brendena/Nordic_Pebble_Steel/README.md

# Nordic steel

The goal of this project is to replace the main motherboard in the pebble steel with newer parts.  Specifically the cpu will be a Nordic NRF52840.
