brendena/Nordic_Pebble_Steel/dev_board/README.md

# Goal
Is to have a dev board to test most of the features for a pebble like watch that runs on a nordic chip.

version
V0.2 - changed the IMU to LSM6DSOXTR, added DRV2605L for motor vibration. Switched the zebra connector around.  Added the zebra connector footprint.  
V0.1 - All most important parts are there.  Spi flash, 2 way of attaching display, Nordic som, charging circuit.
