brendena/Nordic_Pebble_Steel/dev_board/Dev_board_V0.3/README.md

# Changes
* Add i2c pull up resistors
* Connector cap on haptic feedback properly
* connect display signal to the adafruit display connector
* add holes and make board bigger for the watch to be attached to the board
* remove all the battery charging stuff
* on addrafruit display VDD is not connected
* add a 10 pin jtag programmer header
