brendena/Nordic_Pebble_Steel/dev_board/Dev_board_V0.3/Nrf52480_Dev_board/Nrf52480_Dev_board.kicad_pcb

## KiCad design dev_board/Dev_board_V0.3/Nrf52480_Dev_board/Nrf52480_Dev_board.kicad_pcb (2024-08-11)

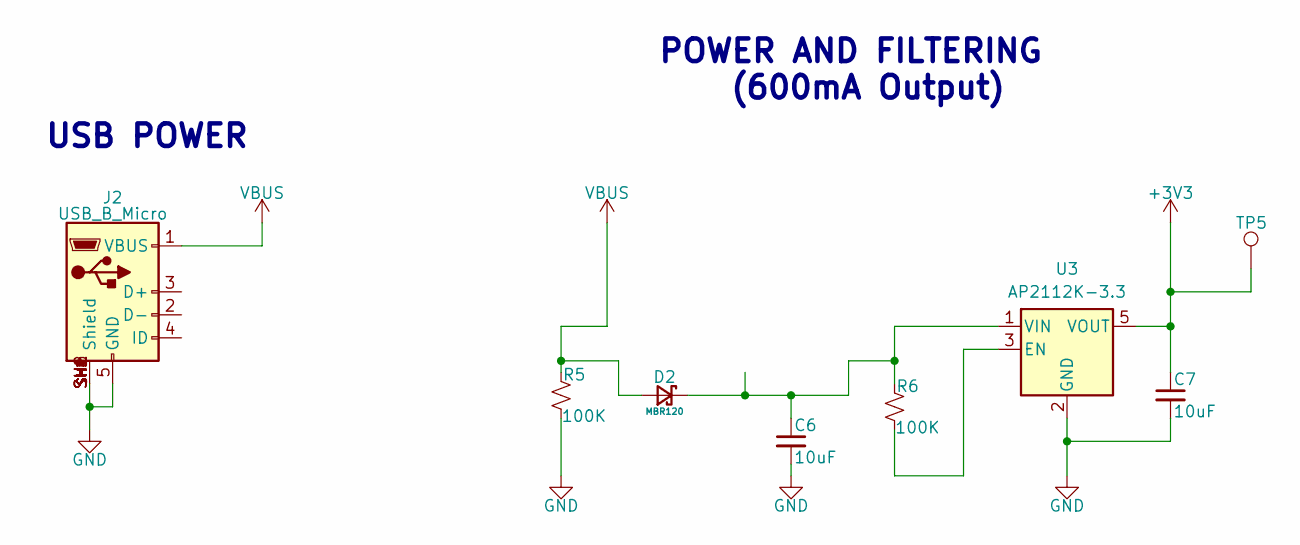
[picture p1: schematic Power.kicad_sch]

Parts:
C6, C7: 10uF; C_0603_1608Metric_Pad1.08x0.95mm_HandSolder
D2: MBR120; D_SOD-123F; MFR# MBR120LSFT1G
J2: USB_B_Micro; MOLEX_1050170001
R5, R6: 100K; R_0603_1608Metric_Pad0.98x0.95mm_HandSolder
TP5: TestPoint; TestPoint_Pad_1.5x1.5mm
U3: AP2112K-3.3; SOT-23-5

Connections:
+3V3: C7.1, TP5.1, U3.5 (VOUT); also elsewhere on the board
GND: C6.2, C7.2, J2.5 (GND), J2.SH1 (Shield), J2.SH2 (Shield), J2.SH3 (Shield), J2.SH4 (Shield), J2.SH5 (Shield), J2.SH6 (Shield), J2.SH7 (Shield), J2.SH8 (Shield), R5.1, U3.2 (GND); also elsewhere on the board
unnamed: C6.1, D2.1 (K), R6.2, U3.1 (VIN)
unnamed: R6.1, U3.3 (EN)
VBUS: D2.2 (A), J2.1 (VBUS), R5.2; also elsewhere on the board

Notes on the sheet:
USB POWER
POWER AND FILTERING (600mA Output)

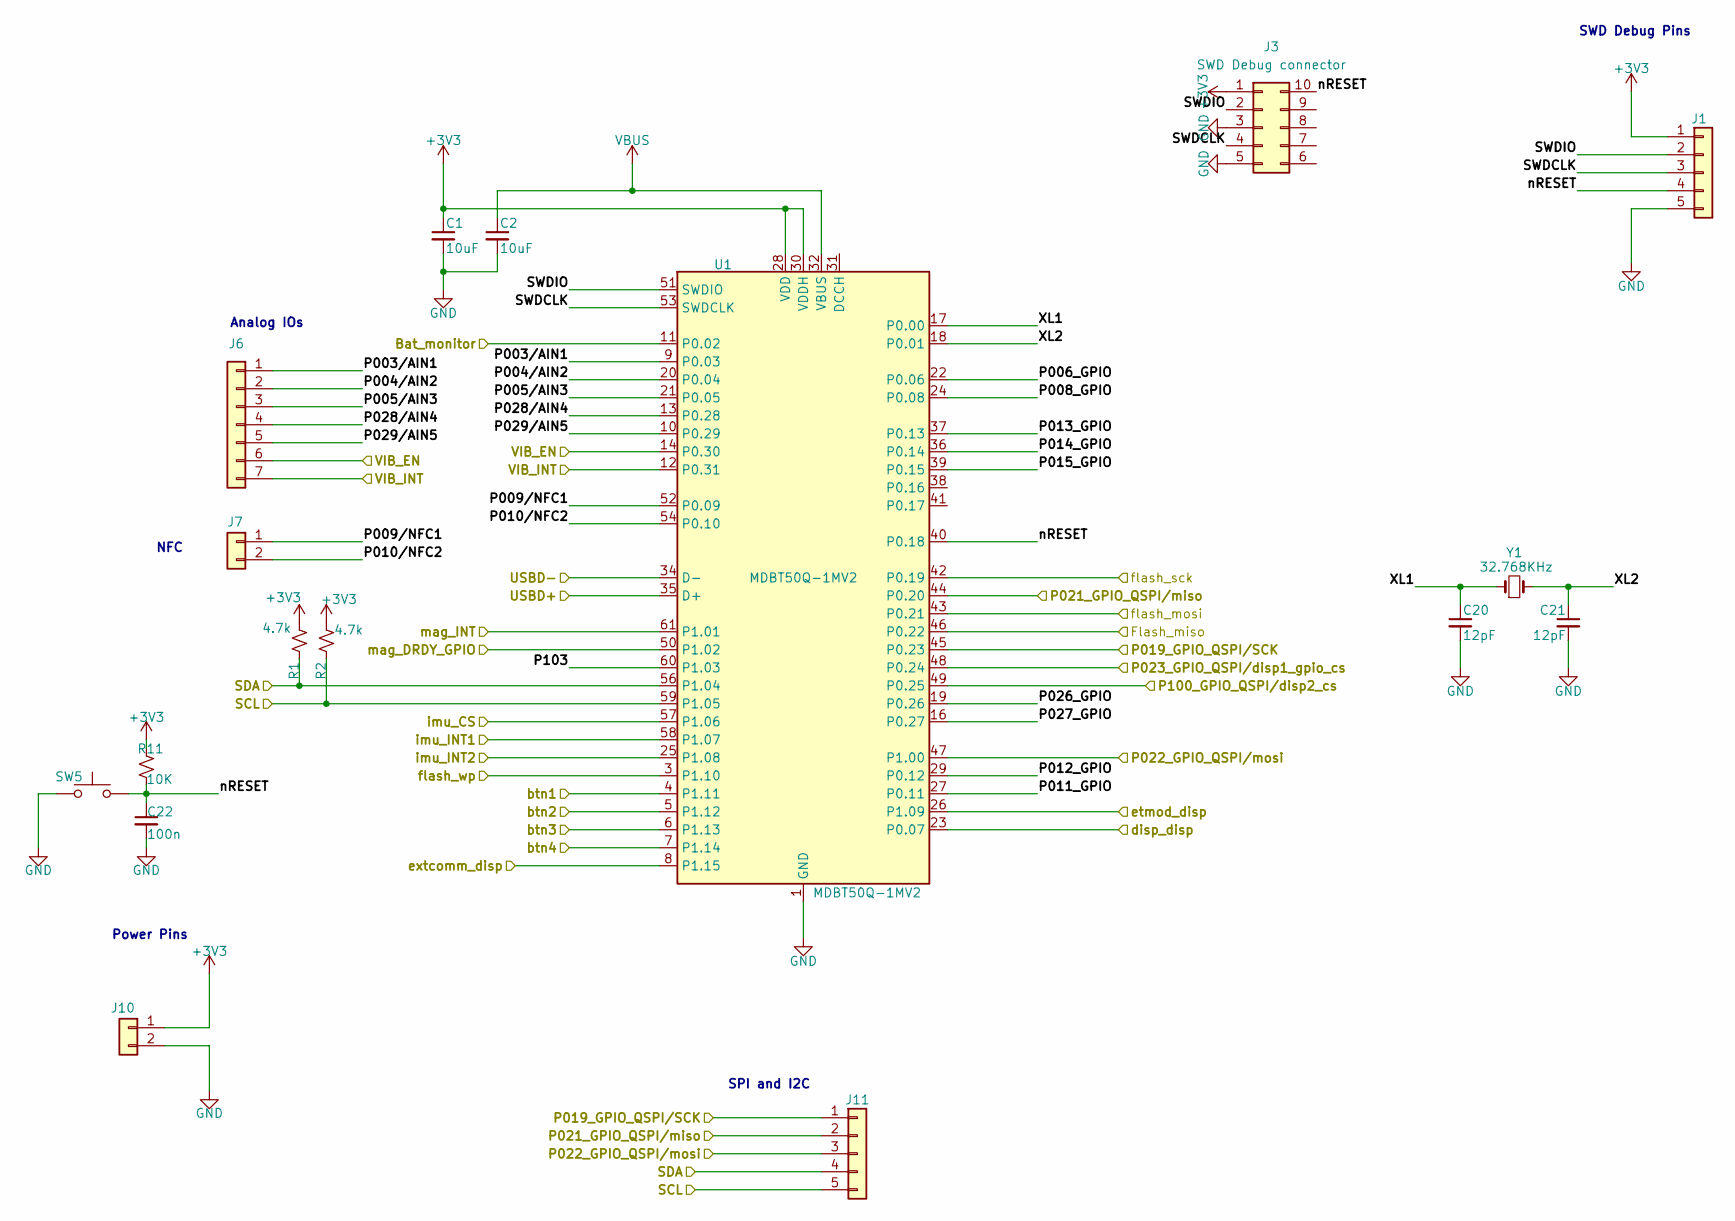
[picture p2: schematic nRF52840.kicad_sch]

Parts:
C1, C2: 10uF; C_0603_1608Metric_Pad1.08x0.95mm_HandSolder
C20, C21: 12pF; C_0603_1608Metric_Pad1.08x0.95mm_HandSolder
C22: 100n; C_0603_1608Metric_Pad1.08x0.95mm_HandSolder
J1, J11: Conn_01x05; PinHeader_1x05_P2.54mm_Vertical
J3: SWD Debug connector; PinHeader_2x05_P1.27mm_Vertical_SMD
J6: Conn_01x07; PinHeader_1x07_P2.54mm_Vertical
J7, J10: Conn_01x02; PinHeader_1x02_P2.54mm_Vertical
R1, R2: 4.7k; R_0603_1608Metric
R11: 10K; R_0603_1608Metric
SW5: SW_Push; SKRPACE010
U1: MDBT50Q-1MV2; Raytac_MDBT50Q; MFR# MDBT50Q-1MV2
Y1: 32.768KHz; Crystal_SMD_3215-2Pin_3.2x1.5mm

Connections:
+3V3: C1.1, J1.1, J3.1, J10.1, R1.1, R2.1, R11.2, U1.28 (VDD), U1.30 (VDDH); also elsewhere on the board
/Sensors/DISP2_CS: U1.49 (P0.25); also elsewhere on the board
/Sensors/Flash_miso: U1.46 (P0.22); also elsewhere on the board
/Sensors/SCL: J11.5, R2.2, U1.59 (P1.05); also elsewhere on the board
/Sensors/SDA: J11.4, R1.2, U1.56 (P1.04); also elsewhere on the board
/Sensors/VIB_EN: J6.6, U1.14 (P0.30); also elsewhere on the board
/Sensors/VIB_INT: J6.7, U1.12 (P0.31); also elsewhere on the board
/Sensors/btn1: U1.4 (P1.11); also elsewhere on the board
/Sensors/btn2: U1.5 (P1.12); also elsewhere on the board
/Sensors/btn3: U1.6 (P1.13); also elsewhere on the board
/Sensors/btn4: U1.7 (P1.14); also elsewhere on the board
/Sensors/disp1_GPIO_CS: U1.48 (P0.24); also elsewhere on the board
/Sensors/disp_disp: U1.23 (P0.07); also elsewhere on the board
/Sensors/etmod_disp: U1.26 (P1.09); also elsewhere on the board
/Sensors/extcomm_disp: U1.8 (P1.15); also elsewhere on the board
/Sensors/flash_mosi: U1.43 (P0.21); also elsewhere on the board
/Sensors/flash_sck: U1.42 (P0.19); also elsewhere on the board
/Sensors/flash_wp: U1.3 (P1.10); also elsewhere on the board
/Sensors/imu_CS: U1.57 (P1.06); also elsewhere on the board
/Sensors/imu_INT1: U1.58 (P1.07); also elsewhere on the board
/Sensors/imu_INT2: U1.25 (P1.08); also elsewhere on the board
/Sensors/mag_DRDY_GPIO: U1.50 (P1.02); also elsewhere on the board
/Sensors/mag_INT: U1.61 (P1.01); also elsewhere on the board
/Sensors/mosi: J11.3, U1.47 (P1.00); also elsewhere on the board
/Sensors/sck: J11.1, U1.45 (P0.23); also elsewhere on the board
/nRF52840/Bat_monitor: U1.11 (P0.02)
/nRF52840/P003/AIN1: J6.1, U1.9 (P0.03)
/nRF52840/P004/AIN2: J6.2, U1.20 (P0.04)
/nRF52840/P005/AIN3: J6.3, U1.21 (P0.05)
/nRF52840/P006_GPIO: U1.22 (P0.06)
/nRF52840/P008_GPIO: U1.24 (P0.08)
/nRF52840/P009/NFC1: J7.1, U1.52 (P0.09)
/nRF52840/P010/NFC2: J7.2, U1.54 (P0.10)
/nRF52840/P011_GPIO: U1.27 (P0.11)
/nRF52840/P012_GPIO: U1.29 (P0.12)
/nRF52840/P013_GPIO: U1.37 (P0.13)
/nRF52840/P014_GPIO: U1.36 (P0.14)
/nRF52840/P015_GPIO: U1.39 (P0.15)
/nRF52840/P021_GPIO_QSPI/miso: J11.2, U1.44 (P0.20)
/nRF52840/P026_GPIO: U1.19 (P0.26)
/nRF52840/P027_GPIO: U1.16 (P0.27)
/nRF52840/P028/AIN4: J6.4, U1.13 (P0.28)
/nRF52840/P029/AIN5: J6.5, U1.10 (P0.29)
/nRF52840/P103: U1.60 (P1.03)
/nRF52840/SWDCLK: J1.3, J3.4, U1.53 (SWDCLK)
/nRF52840/SWDIO: J1.2, J3.2, U1.51 (SWDIO)
/nRF52840/USBD+: U1.35 (D+)
/nRF52840/USBD-: U1.34 (D-)
/nRF52840/XL1: C20.1, U1.17 (P0.00), Y1.1
/nRF52840/XL2: C21.1, U1.18 (P0.01), Y1.2
/nRF52840/nRESET: C22.1, J1.4, J3.10, R11.1, SW5.2, U1.40 (P0.18)
GND: C1.2, C2.2, C20.2, C21.2, C22.2, J1.5, J3.3, J3.5, J10.2, SW5.1, U1.1 (GND), U1.2 (GND), U1.15 (GND), U1.33 (GND), U1.55 (GND); also elsewhere on the board
VBUS: C2.1, U1.32 (VBUS); also elsewhere on the board

Notes on the sheet:
Analog IOs
Power Pins
SPI and I2C
SWD Debug Pins
NFC

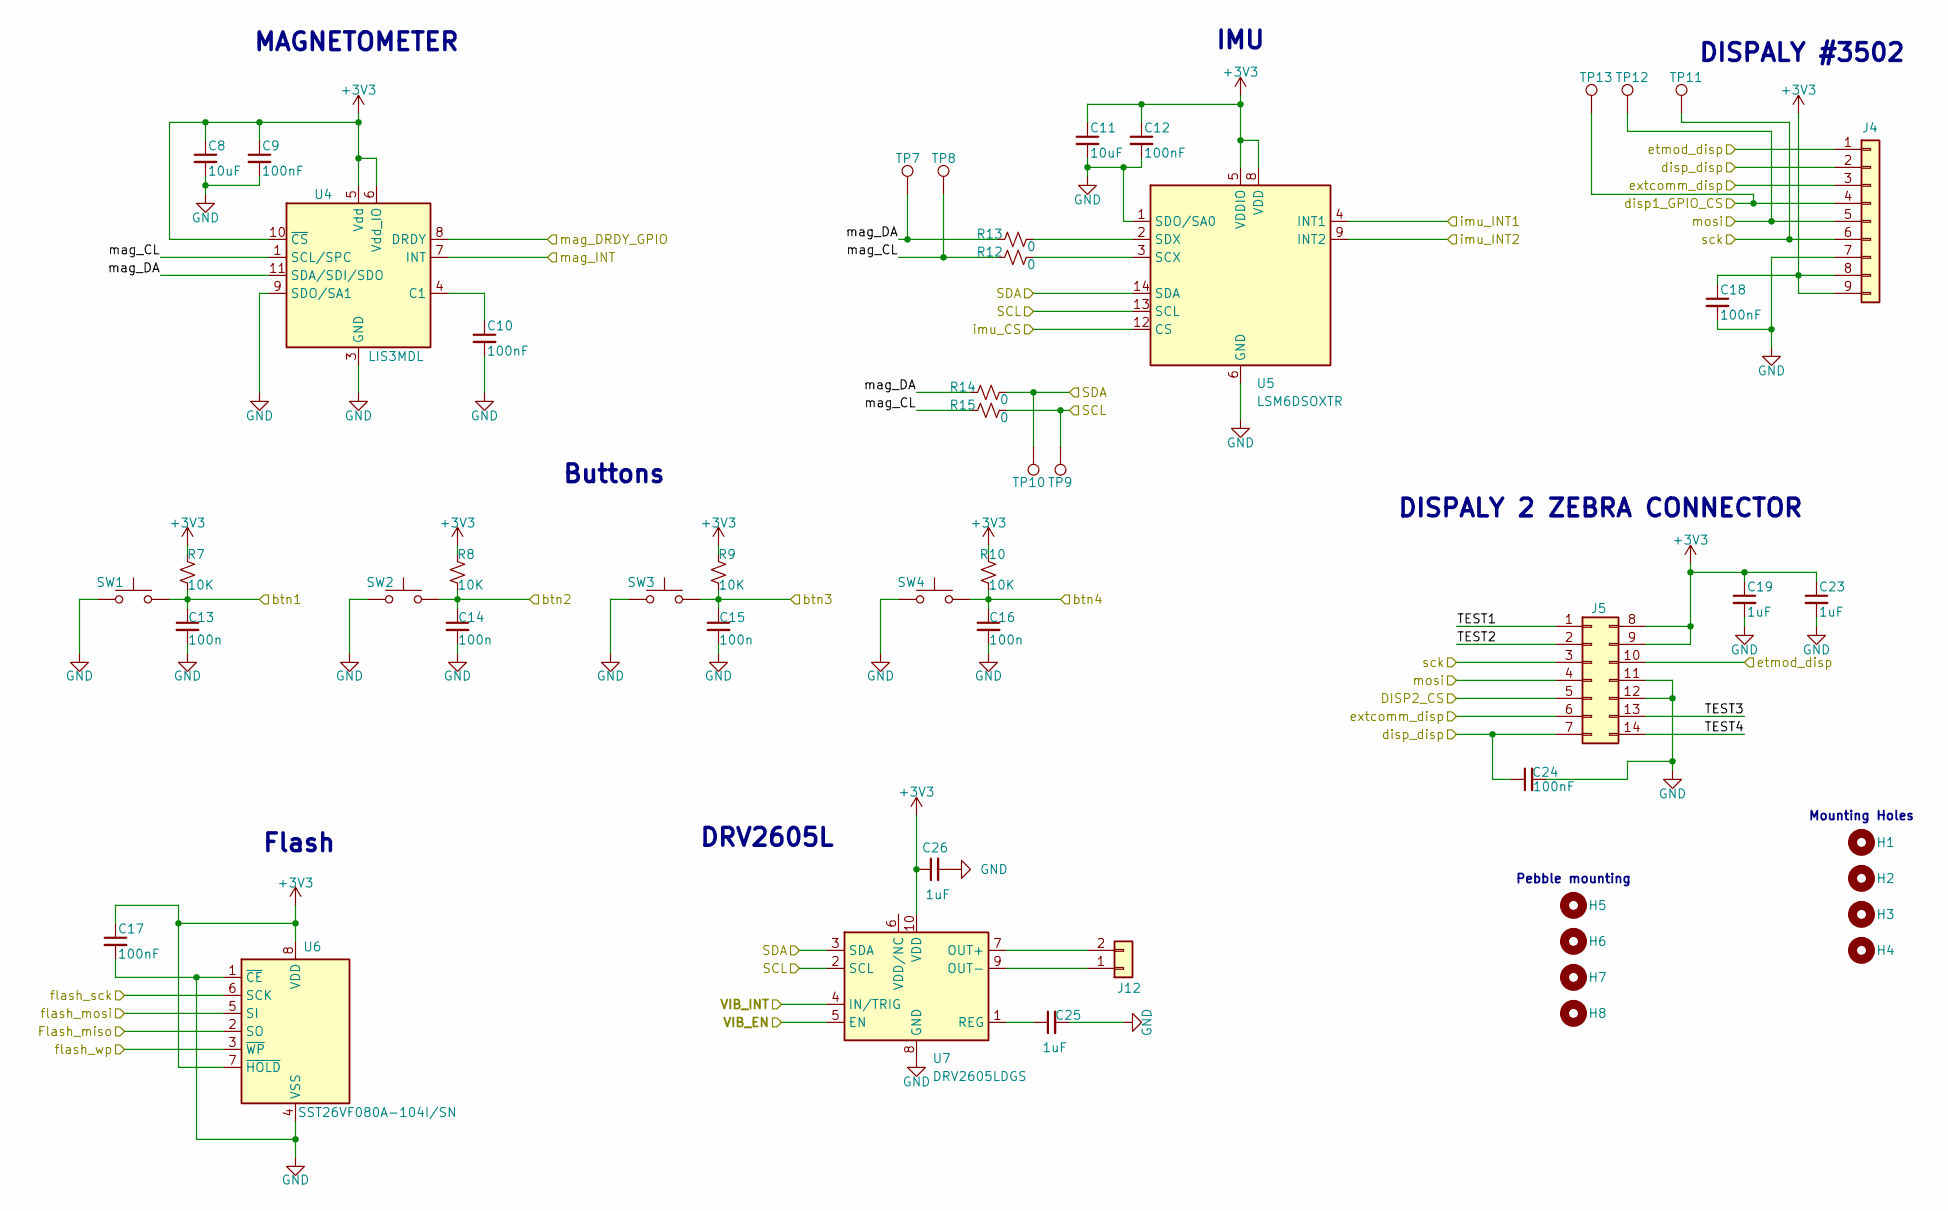
[picture p3: schematic Sensors.kicad_sch]

Parts:
C8, C11: 10uF; C_0603_1608Metric_Pad1.08x0.95mm_HandSolder
C9, C10, C12, C17, C18, C24: 100nF; C_0603_1608Metric_Pad1.08x0.95mm_HandSolder
C13, C14, C15, C16: 100n; C_0603_1608Metric_Pad1.08x0.95mm_HandSolder
C19, C23, C25, C26: 1uF; C_0603_1608Metric_Pad1.08x0.95mm_HandSolder
H1, H2, H3, H4: MountingHole; MountingHole_3.2mm_M3
H5, H6, H7, H8: MountingHole; MountingHole_2.1mm
J4: Conn_01x09; PinHeader_1x09_P2.54mm_Vertical
J5: Conn_02x07_Top_Bottom; Zebra_LS013B7DH01
J12: Conn_01x02; PinHeader_1x02_P2.54mm_Vertical
R7, R8, R9, R10: 10K; R_0603_1608Metric
R12, R13, R14, R15: 0; R_0603_1608Metric
SW1, SW2, SW3, SW4: SW_Push; SKRPACE010
TP7, TP8, TP9, TP10, TP11, TP12, TP13: TestPoint; TestPoint_Pad_1.5x1.5mm
U4: LIS3MDL; LGA-12_2x2mm_P0.5mm; MFR# LIS3MDLTR
U5: LSM6DSOXTR; LGA-14_3x2.5mm_P0.5mm_LayoutBorder3x4y; MFR# LSM6DSO16ISTR
U6: SST26VF080A-104I/SN; SOIC-8_3.9x4.9mm_P1.27mm; MFR# SST26VF080A-104I/SN
U7: DRV2605LDGS; VSSOP-10_3x3mm_P0.5mm

Connections:
+3V3: C8.1, C9.1, C11.1, C12.1, C17.1, C18.1, C19.1, C23.1, C26.1, J4.8, J4.9, J5.8, J5.9, R7.2, R8.2, R9.2, R10.2, U4.5 (Vdd), U4.6 (Vdd_IO), U4.10 (~CS), U5.5 (VDDIO), U5.8 (VDD), U6.7 (~HOLD), U6.8 (VDD), U7.10 (VDD); also elsewhere on the board
/Sensors/DISP2_CS: J5.5; also elsewhere on the board
/Sensors/Flash_miso: U6.2 (SO); also elsewhere on the board
/Sensors/SCL: R15.1, TP9.1, U5.13 (SCL), U7.2 (SCL); also elsewhere on the board
/Sensors/SDA: R14.1, TP10.1, U5.14 (SDA), U7.3 (SDA); also elsewhere on the board
/Sensors/TEST1: J5.1
/Sensors/TEST2: J5.2
/Sensors/TEST3: J5.13
/Sensors/TEST4: J5.14
/Sensors/VIB_EN: U7.5 (EN); also elsewhere on the board
/Sensors/VIB_INT: U7.4 (IN/TRIG); also elsewhere on the board
/Sensors/btn1: C13.1, R7.1, SW1.2; also elsewhere on the board
/Sensors/btn2: C14.1, R8.1, SW2.2; also elsewhere on the board
/Sensors/btn3: C15.1, R9.1, SW3.2; also elsewhere on the board
/Sensors/btn4: C16.1, R10.1, SW4.2; also elsewhere on the board
/Sensors/disp1_GPIO_CS: J4.4, TP13.1; also elsewhere on the board
/Sensors/disp_disp: C24.1, J4.2, J5.7; also elsewhere on the board
/Sensors/etmod_disp: J4.1, J5.10; also elsewhere on the board
/Sensors/extcomm_disp: J4.3, J5.6; also elsewhere on the board
/Sensors/flash_mosi: U6.5 (SI); also elsewhere on the board
/Sensors/flash_sck: U6.6 (SCK); also elsewhere on the board
/Sensors/flash_wp: U6.3 (~WP); also elsewhere on the board
/Sensors/imu_CS: U5.12 (CS); also elsewhere on the board
/Sensors/imu_INT1: U5.4 (INT1); also elsewhere on the board
/Sensors/imu_INT2: U5.9 (INT2); also elsewhere on the board
/Sensors/mag_CL: R12.2, R15.2, TP8.1, U4.1 (SCL/SPC)
/Sensors/mag_DA: R13.2, R14.2, TP7.1, U4.11 (SDA/SDI/SDO)
/Sensors/mag_DRDY_GPIO: U4.8 (DRDY); also elsewhere on the board
/Sensors/mag_INT: U4.7 (INT); also elsewhere on the board
/Sensors/mosi: J4.5, J5.4, TP12.1; also elsewhere on the board
/Sensors/sck: J4.6, J5.3, TP11.1; also elsewhere on the board
GND: C8.2, C9.2, C10.2, C11.2, C12.2, C13.2, C14.2, C15.2, C16.2, C17.2, C18.2, C19.2, C23.2, C24.2, C25.2, C26.2, J4.7, J5.11, J5.12, SW1.1, SW2.1, SW3.1, SW4.1, U4.2 (GND), U4.3 (GND), U4.9 (SDO/SA1), U4.12 (GND), U5.1 (SDO/SA0), U5.6 (GND), U5.7 (GND), U6.1 (~CE), U6.4 (VSS), U7.8 (GND); also elsewhere on the board
unnamed: J12.1, U7.9 (OUT-)
unnamed: J12.2, U7.7 (OUT+)
unnamed: C10.1, U4.4 (C1)
unnamed: R12.1, U5.3 (SCX)
unnamed: R13.1, U5.2 (SDX)
unnamed: C25.1, U7.1 (REG)

Notes on the sheet:
MAGNETOMETER
DISPALY #3502
Buttons
Mounting Holes
DISPALY 2 ZEBRA CONNECTOR
Pebble mounting
Flash
IMU
DRV2605L

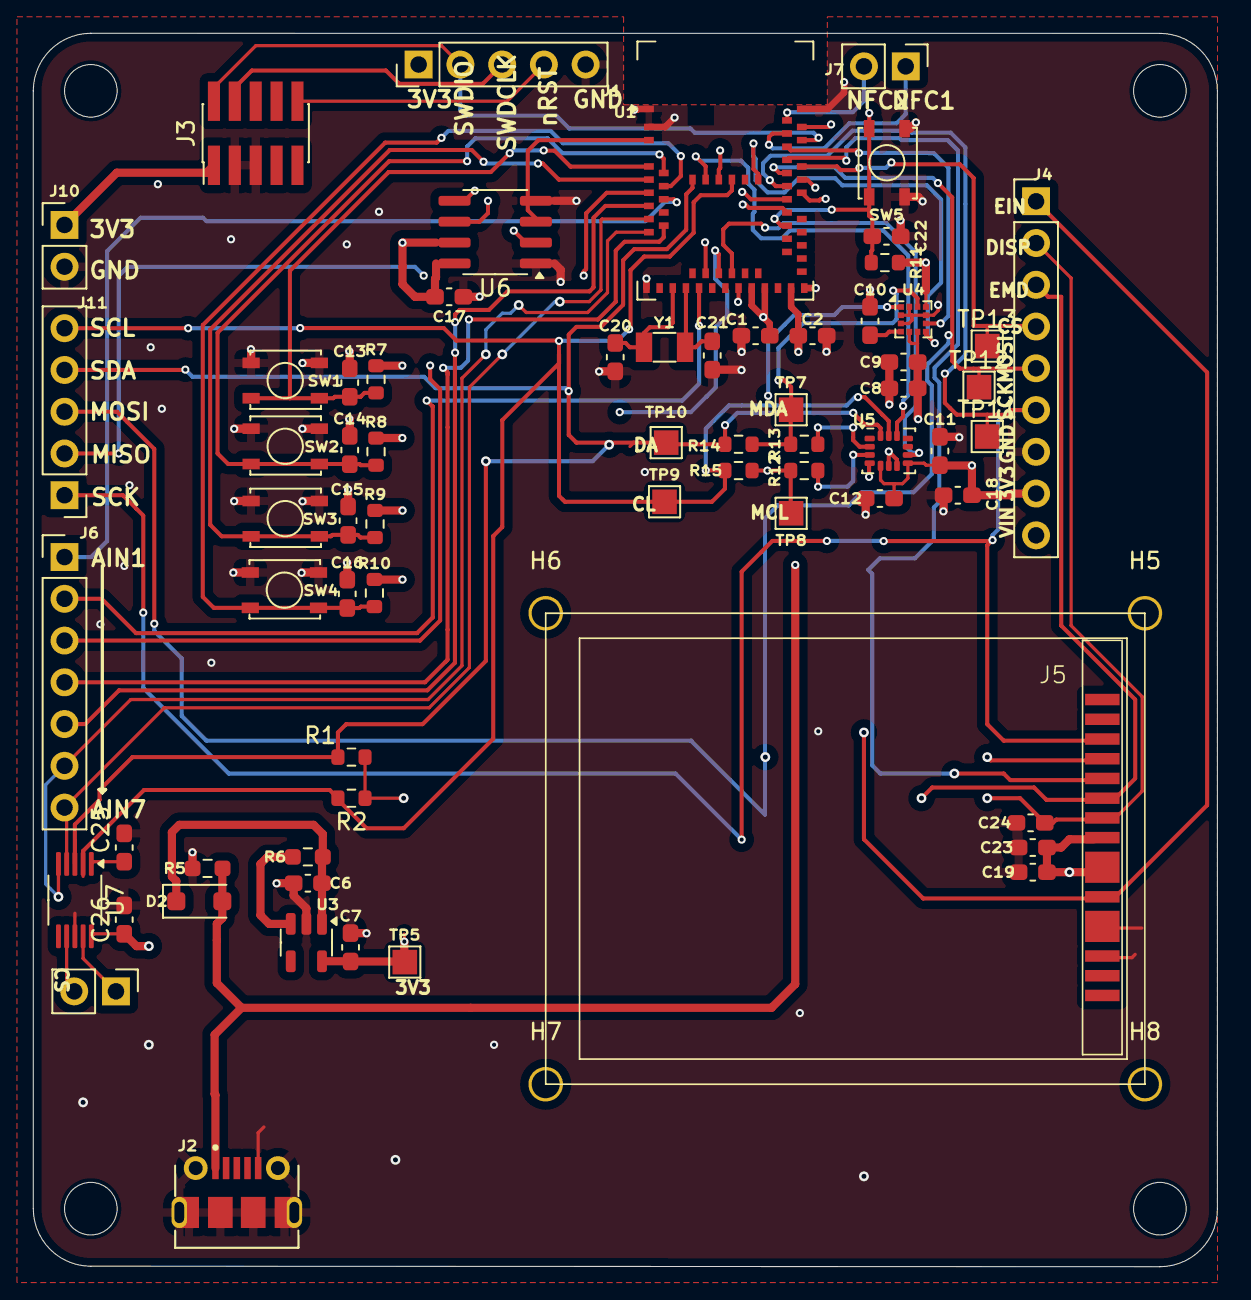
[picture p4: board Nrf52480_Dev_board.kicad_pcb from above]

Board: 4 copper layers, 72.0 x 75.0 mm, 75 parts (0 on the bottom side), 50 nets.
