brendena/Nordic_Pebble_Steel/production_test/README.md

V1 - First board layout  (never produced)

V2 - Changed out the power management chip.  
### REASON

* 2 button power reset
* Better battery estimate built in
* UI for register settings 
* cheaper
