brendena/Nordic_Pebble_Steel/(commit log)

2024-03-21 added dev board
2024-05-17 uploaded the real dev board 0.2
2024-06-01 added v3 version almost done. Just have to adjust the holes
    [Nrf52480_Dev_board.kicad_pcb, Nrf52480_Dev_board.kicad_sch, Power.kicad_sch, Sensors.kicad_sch, nRF52840.kicad_sch]
2024-06-01 lined the holes up
    [Nrf52480_Dev_board.kicad_pcb]
2024-06-01 lined up the holes
2024-06-11 added rev v1 of the production board
2024-06-30 added the power managment chip
2024-08-11 updated BOM
    [Nrf52480_Dev_board.kicad_pcb, Sensors.kicad_sch, nRF52840.kicad_sch]
